Ronnie772/Ronnie772.github.io/docs/index.md

---
title: Welcome
tags:
- tag1
- tag2
---
<center>
<font size = "6">Raunak Singh Datasheet</font><br>
as part of<br>
<font size= "8"> Garden Buddy</font><br>
for<br>
<font size= "5"> Team 201 </font><br>

**Submission: DEC/08/2025**
</center>

after_soldering_front

## Introduction

* These pages describe the construction of the motor subsystem for the Garden Buddy.

<br> 

### Project Summary

* Our goal witht the Garden Buddy is to bring automation to the green thumb so that everyone can enjoy a green and healthy environment at the comfort of their homes.
* We have desgined a moisture sensor that detects the hydration of the soil and lets our motor subsystem know when to open and close the valves to the water tank, irrigating the soil and maintaining the plants. We have a light sensor and a speaker that lets the user know when there isn't enough light or if the water tank is empty. 

<br>

### My Contribution

* My part of the project was to design, build and test th emotor subsystem. This smart irrigation system "Garden Buddy" detects the hydration of the soil and opens the water valves to irrigate the soil keeping the plant healthy and ensuring their long life with minimal user interaction.

* To review the detials of the Block Diagram click [*here*](https://ronnie772.github.io/01-Block-Diagram/Block-Diagram/)

* To review the detials of the Component Selection process click [*here*](https://ronnie772.github.io/02-Component-Selection/Component-Selection/)

* To review the detials of the Schematic click [*here*](https://ronnie772.github.io/04-Schematic/schematic/)

* To review the detials of the Power Budget click [*here*](https://ronnie772.github.io/05-Power-Budget/Power-Budget/)

<br>

Team Report can be found [*here*](https://asu-egr304-2025-f-201.github.io/).

---
| **Team Member** |**Ind. Datasheet Links** |
| --- | ---|
| Jacob Alger | [JacobAlger.GitHub](https://jacob-alger.github.io/)|
| Isaiah Johnston | [Isaiahcmd.GitHub](https://isaiahcmd.github.io/)|
| Rylee Wirt | [rmwirt-source.GitHub](https://rmwirt-source.github.io)|
