Ronnie772/Ronnie772.github.io/docs/06-PCB-Design/06-PCB-Design.md

---
title: PCB - Design
---

## Overview
The PCB for Motor Subsystem of Garden Buddy project implements the PIC18F57Q43 Curiosity Nano, the FAN8100N H-bridge driver, and connectors for the Pololu DC motor and team sensor interfaces. A 9v barrel jack supplies power to the onboard LM7805 linear regulator, which generates the regulated 5v rail used by the microcontroller, H-bridge, indicator LED, and override switches. Additional components such as pull-down resistors, bypass capacitors, and the safety override switches are placed to ensure stable operation and simplify testing.

<br>

3D rendered PCB image (KiCAD)


<br>

Top layer image of PCB (before soldering)
before_soldering_front

<br>

Bottom layer of PCB (before soldering)
before_soldering_back

<br>

Top layer of the PCB (after partial soldering)
after_soldering_front

<br>

Bottom layer of the PCB (after partial Soldering)
after_soldering_back

## Resouces

All the gbr & drl files can be found in the zip file [*here*](https://github.com/user-attachments/files/23944338/gbr.drl_files_PCB_GARDEN_BUDDY.zip),
and the ecad project files can be found [*here*](https://github.com/user-attachments/files/23466681/subsystem-all-project-ecad-files.egr304-RSC.zip).
