Ronnie772/Ronnie772.github.io/docs/09 Resources/09 Resources.md

---
title: Resources
tags:
- tag1
- tag2
---
## Overview
The Resources section provides all design files and supporting documentation necessary to review, replicate, or further develop the motor subsystem hardware and firmware. This includes the full MPLAB project used to program and test the PIC18F57Q43 microcontroller, as well as the complete KiCad project files for the motor subsystem PCB. Together, these files offer a comprehensive reference for both the electrical design and embedded software used in the Garden Buddy system.

The MPLAB project contains the source code, configuration settings, and MCC-generated drivers that implement PWM motor control, override logic, sensor interfacing, and subsystem communication. These files allow future developers to rebuild, modify, or extend the firmware without recreating the environment from scratch.

The KiCad project provides the schematic, PCB layout, component libraries, and fabrication outputs for Hardware V1.0 of the motor subsystem. These resources support hardware debugging, revision planning, and the development of an improved Hardware V2.0 design. Gerber files, BOMs, 3D models, and manufacturing notes are also included to facilitate board fabrication and assembly.

[Block diagram PDF](https://github.com/user-attachments/files/23423738/block-diagram-RSC.drawio.1.pdf).

[Schematic PDF](https://github.com/user-attachments/files/23864050/Subsystem-schematic-design-RSC-.pdf)

[BOM xlsx](https://github.com/user-attachments/files/23973200/Bill_of_Materials_egr304.xlsx)

[MPLAB X PROJECT](https://github.com/user-attachments/files/24046420/Subsystem-Motor_egr304_.zip)

[GBR & DRL files from KiCAD](https://github.com/user-attachments/files/23944338/gbr.drl_files_PCB_GARDEN_BUDDY.zip)

[ecad project files from KiCAD](https://github.com/user-attachments/files/23466681/subsystem-all-project-ecad-files.egr304-RSC.zip).
