Ronnie772/Ronnie772.github.io/docs/05-Power-Budget/Power-budget-rsc.pdf

Team Number: | Team 201
Project Name: | Garden Buddy
Team Member Names: | Raunak Singh Chhabra, Isaiah Johnston, Jacob Alger, Rylee Wirt
Version: | 1
All Major Components Component Name Part Number Supply Voltage Range # Absolute Maximum Current (mA) | Total Current (mA) | Unit
Motor M1N1FB11G 1V to 6V 1 1100 | 1100 mA
Barrel Jack | PJ-102AH | 24V | 1 | 5000 | 5000 mA
5V regulator | LM7805T | 7V to 35V | 2 | 1500 | 3000 mA
Curiosity Nano Board | PIC18F57Q43 | 1.8V to 5.5V | 1 | 500 | 500 mA
+5V Power Rail (1) Component Name Part Number Supply Voltage Range # Absolute Maximum Current (mA) | Total Current (mA) | Unit
Curiosity Nano Board PIC18F57Q43 1.8V to 5.5V 1 500 Subtotal Safety Margin Total Current Required on +5V Rail c3. Regulator or Source Choice 5V regulator LM7805T 7V to 35V 1 1500 Total Remaining Current Available on +5V Rail | 500 mA 500 mA 25% 625 mA 1500 mA 875 mA | mA
+5V Power Rail (2) Component Name Part Number Supply Voltage Range # Absolute Maximum Current (mA) | Total Current (mA) | Unit
Motor M1N1FB11G 1V to 6V 1 1200 Subtotal Safety Margin Total Current Required on +5V Rail c2. Regulator or Source Choice 5V regulator LM7805T 7V to 35V 1 1500 Total Remaining Current Available on +5V Rail | 1200 mA 1200 mA 25% 1500 mA 1500 mA 0 mA | mA
+9V Power Rail Component Name Part Number Supply Voltage Range # Absolute Maximum Current (mA) | Total Current (mA) | Unit
5V regulator LM7805T 7V to 35V 1 1500 5V regulator LM7805T 7V to 35V 1 1500 Subtotal Safety Margin Total Current Required on +9V Rail c1. Regulator or Source Choice Barrel Jack PJ-102AH 24V 1 5000 Total Remaining Current Available on +9V Rail | 1500 mA 1500 3000 mA 25% 3750 mA 5000 mA 1250 mA
C. For each power rail above,

# Power Budget for Motor - Raunak Singh

A. List ALL major components (active devices, integrated circuits, etc.) except for power sources, voltage regulators, resistors, capacitors, or passive elements
B. Assign each major component above to ONE power rail below. Try to minimize the number of different power rails in the design.

D. Select a specific external
External Power Source 1 Component Name Part Number Supply Voltage Range Output Voltage Absolute Maximum Current (mA) | Total Current (mA) | Unit
Power Source 1 Selection Plug-in Wall Supply B09ZTKTLGW 110VAC 9V 15000 15000 mA Barrel Jack PJ-102AH 24V 9V 5000 5000 mA
E. Calculate Battery Life (if applicable). For each battery, also check the worst-case lifetime of the battery by indicating the capacity in mAh.
Power Rails Connected to | 5V regulator | LM7805T | 7V to 35V | 5V | 1500 | 1500 mA
| 5V regulator | LM7805T | 7V to 35V | 5V | 1500 | 1500 mA
| | | | | | 7000 mA
Component Name | Part Number | Supply Voltage Range | Capacity (mAh) | Required By Regulators
#REF!

Battery Life | #REF! | hours
Notes
be determined by the dropout design (e.g., a base unit and

Total Remaining Current Available on External Power Source 1
