Ronnie772/Ronnie772.github.io/docs/01-Block-Diagram/block-diagram-RSC.drawio.pdf

| Raunak Sin
| Microchip PIC18F57Q43 Curio
| Digital I/O
RA1 | | RB2 | RC4 | RD0 | RD

Button

RA0 | ADC1
RA1 | ADC2

connector 1

digital | analog
1 | 2 | 3 | 4 | 5 | 6 | 7 | 8

connecto

digital

1 | 2 | 3 | 4 | 5

5V 1.5A voltage regulator

(5v, 1pin)

9V 3A
unregulated
power supply

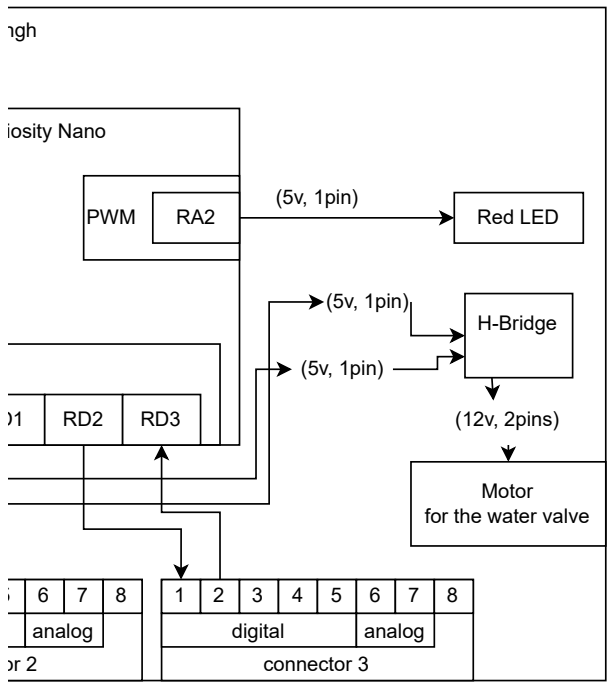
[picture p1: figure]
ngh; iosity Nano; H-Bridge; Motor for the water valve; PWM; Red LED; analog; connector 3; digital; (5v, 1pin); (12v, 2pins)
