Ronnie772/Ronnie772.github.io/docs/01-Block-Diagram/Screenshot 2025-10-21 174000.png

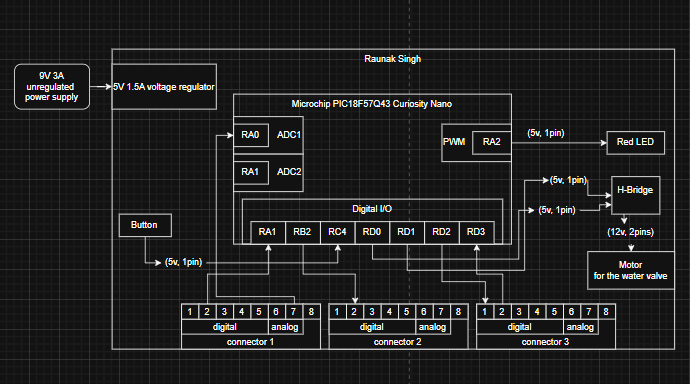
docs/01-Block-Diagram/Screenshot 2025-10-21 174000.png
