Ronnie772/Ronnie772.github.io/docs/04-Schematic/Screenshot 2025-10-20 232314.png

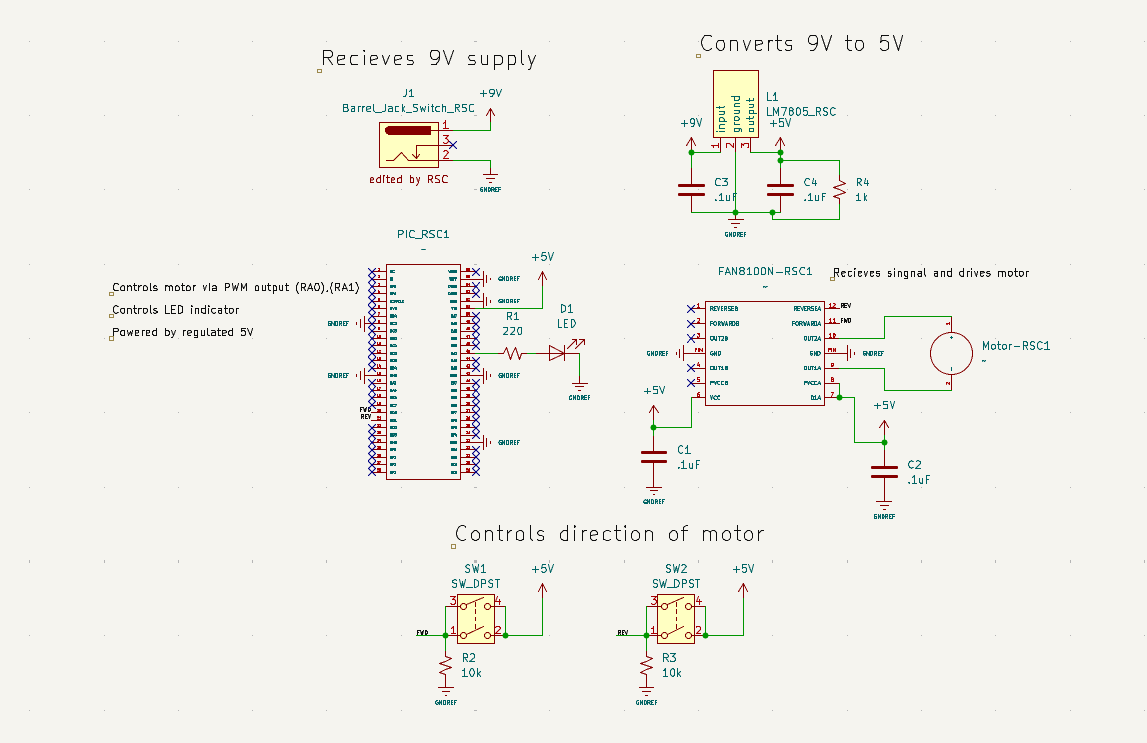
docs/04-Schematic/Screenshot 2025-10-20 232314.png
