Ronnie772/Ronnie772.github.io/docs/04-Schematic/Screenshot 2025-10-22 221519.png

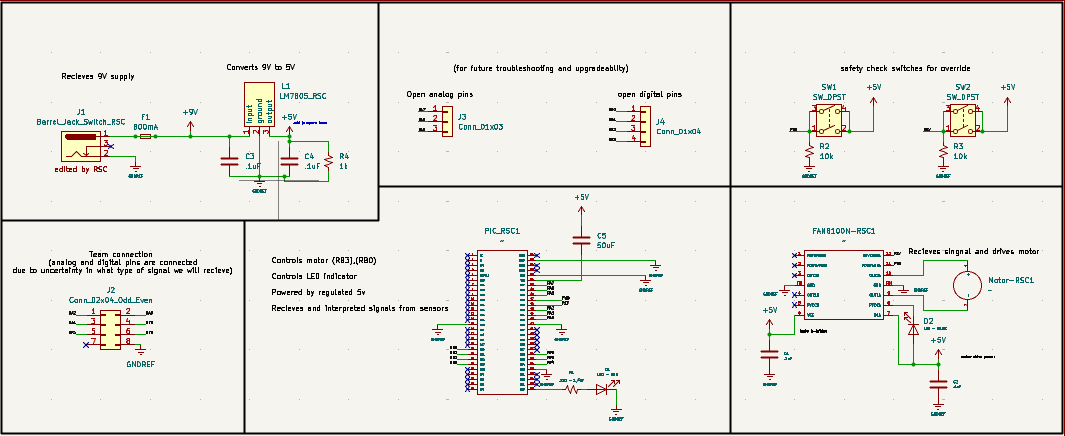
docs/04-Schematic/Screenshot 2025-10-22 221519.png
