Ronnie772/Ronnie772.github.io/docs/04-Schematic/Screenshot 2025-10-27 022820.png

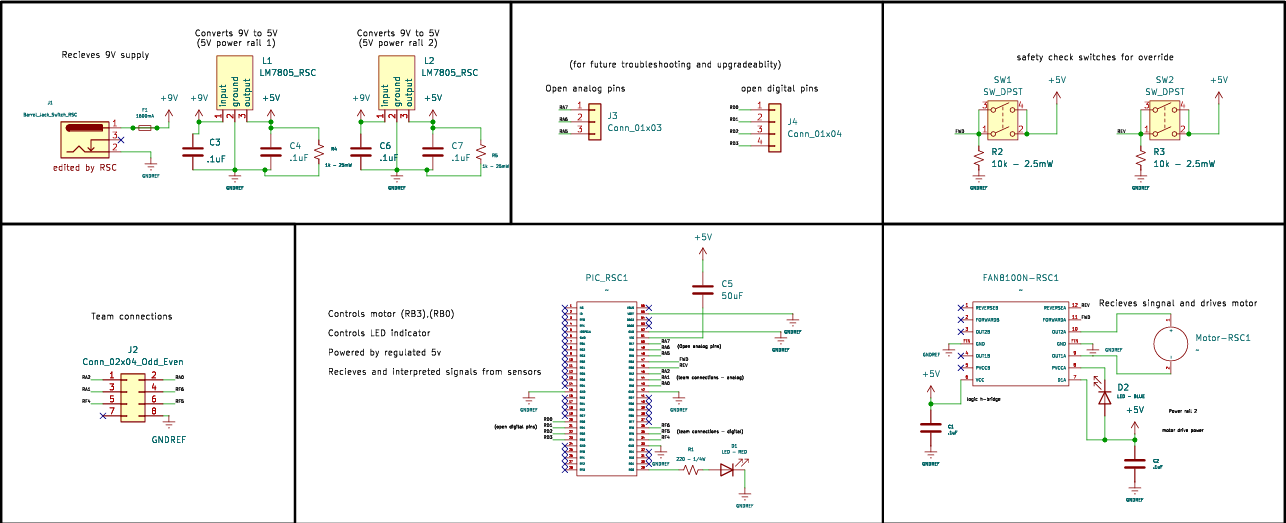
docs/04-Schematic/Screenshot 2025-10-27 022820.png
