Ronnie772/Ronnie772.github.io/docs/03-BOM/BOM.md

---
title: Bill of Materials
tags:
- tag1
- tag2
---

## Overview

This image serves as a complete bill of materials (BOM) for the motor subsystem design, outlining every item needed to assemble the motor subsystem for the Garden Buddy project, it serves as the main reference for the procurement of parts and cost estimation. All the components are readily available through Digi-Key, Amazon and Microchip-Technology and the total cost of the subsystem is,                      

$$ 
$52.20 + $3.20 = $55.40
$$  

<p align="right">{the 5 outsourced JLC PCBs = $3.20}</p>

## Bill of Materials 



You can find the xlsx file [*here*](https://github.com/user-attachments/files/23973200/Bill_of_Materials_egr304.xlsx)
