Ronnie772/Ronnie772.github.io/docs/02-Component-Selection/Component-Selection.md

---
title: Component Selection 
---

**Voltage Regulator**

1. NJM7805FA

   

   * $1.7
   * [Link to product](http://digikey.com/en/products/detail/nisshinbo-micro-devices-inc/NJM7805FA/805763)
  
    | Pros                                                              | Cons                |
    | ----------------------------------------------------------------- | ------------------- |
    | Lightweight                                                       | Higher price |
    |                                                                   |Working temp lower (max- 85°C) |

2. LM7805T

   

   * $0.33
   * [Link to product](https://www.digikey.com/en/products/detail/taejin/LM7805T/22237260)
  
    | Pros                                                              | Cons                |
    | ----------------------------------------------------------------- | ------------------- |
    | From the kit                                                      | Only sold in bulk ($33/100) |
    | Inexpensive                                                       |                      |

3. LM7805R

   

   * $0.33
   * [Link to product](https://www.digikey.com/en/products/detail/taejin/LM7805R/22237269)
  
    | Pros                                                              | Cons                |
    | ----------------------------------------------------------------- | ------------------- |
    | Surface mount                                                     | Only sold in bulk ($266.66/800) |
    | Better  thermal conductivity                                      |                      |

**Choice:** Option 2: LM7805T

**Rationale:** The LM7805T has a 5V 1500mA output, it is inexpensive and efficient, the output matches our requerments perfectly and fits the power budget as well, since it is one of th parts provided by the class it makes most sense to choose this voltage regulator.

**Motors**

1. M1N10FB11G 5V motor

     

    * $3.19/each
    * [link to product]((https://www.digikey.com/en/products/detail/nmb-technologies-corporation/M1N10FB11G/2417078))

    | Pros                                      | Cons                           |
    | ----------------------------------------- | ------------------------------ |
    | Inexpensive                               | Low torque                     |
    | Perfectly matches 5V rail                 | Tendency to spike in amperage when turned on |
    | Lightweight                               | Requires a diffrent Voltage regulator |
    | Available for bulk order for replacements |                                |
   
2. SE15K1BTYJ 12V motor
   
    

    * $9.24/each
    * [Link to product](https://www.digikey.com/en/products/detail/nmb-technologies-corporation/SE15K1BTYJ/6021448)

    | Pros                                                              | Cons                |
    | ----------------------------------------------------------------- | ------------------- |
    | Higher Torque                                                     | Higher Price        |
    | Small and compact                                                 | Requires a diffrent Voltage regulator |

3. 2371 6V motor (Pololu)

   

   * $23.95
   * [Link to product](https://www.digikey.com/en/products/detail/pololu/2371/10450018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)

    | Pros                                                              | Cons                |
    | ----------------------------------------------------------------- | ------------------- |
    | Highest Torque                                                    | Higher Price        |
    | Small and compact                                                 | Low RPM             |
    | Doesn't require an additional power rail                          |                     |
    | Lightweight                                                       |                     |
    
**Choice:** Option 3: 2371 6V motor (Pololu)

**Rationale:** The 2371 6v motor by Pololu is perfect match for our 5v power rail and eliminates the need for an extra one, keeping the PCB design simple. It is lightweight and has the highest toque output, therefore saving cost and increasing productivity.

**H-Bridge**

1. FAN8100N

   

   * $1.16
   * [Link to product](https://www.digikey.com/en/products/detail/rochester-electronics-llc/FAN8100N/11558200)
  
    | Pros                                                              | Cons                |
    | ----------------------------------------------------------------- | ------------------- |
    | From the kit                                                      | Low working temp (75°C) |
    | Through hole                                                      |                     |

2. DRV8833PWPR

   

   * $2.6
   * [Link to product](https://www.digikey.com/en/products/detail/texas-instruments/DRV8833PWPR/2743167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)
  
    | Pros                                                              | Cons                |
    | ----------------------------------------------------------------- | ------------------- |
    | Built-in overcurrent and undervoltage protection                  | Higher price        |
    | Higher working temp (150°C)                                       |                     |
    | Surface mount                                                     |                     |

3. TB6615PG,8

   

   * $2.09
   * [Link to product](https://www.digikey.com/en/products/detail/toshiba-semiconductor-and-storage/tb6615pg-8/7809551)
  
    | Pros                                                              | Cons                |
    | ----------------------------------------------------------------- | ------------------- |
    | Higher working temp (85°C)                                        | Package arrival too late |
    | Fewer pins                                                        |                     |
    | Through hole                                                      |                     |

**Choice:** Option 1: FAN8100N 

**Rationale:** This FAN8100N is an inexpensive and efficient component that fits our requirements perfectly since it is part of the kit provided by the class it also eliminates the need to order an external part, therefore saving cost and increasing productivity. 

**Barrel Jack**

1. PJ-102AH
   
   

   * $0.76
   * [Link to product](https://www.digikey.com/en/products/detail/cui-devices/PJ-102AH/408448)
  
    | Pros                                                              | Cons                |
    | ----------------------------------------------------------------- | ------------------- |
    | From the kit                                                      | Side load fragility |
    | Polybutylene Terephthalate for housing                            |                     |
    |                                                                   |                     |

2. PJ-202A
   
   

   * $0.7
   * [Link to product](https://www.digikey.com/en/products/detail/same-sky-formerly-cui-devices/pj-202a/252007)
  
    | Pros                                                              | Cons                |
    | ----------------------------------------------------------------- | ------------------- |
    | Polybutylene Terephthalate for housing                            | Lower current rating |
    |                                                                   | Package arrival too late |

3. RAPC722X
   
   

   * $2.01
   * [Link to product](https://www.digikey.com/en/products/detail/switchcraft-inc/rapc722x/804747)
  
    | Pros                                                              | Cons                |
    | ----------------------------------------------------------------- | ------------------- |
    | Better solder joint reliability                                   | Higher price |
    |                                                                   |Housing material specified as thermoplastic no specifications given |

**Choice:** Option 1: PJ-102AH

**Rationale:** The PJ-102AH is an inexpensive and highly efficient barrel jack switch, it is part of the kit provided by the class and it fulfills our requirements hence eliminating the need to order an external part, saving cost and increasing productivity.

<br>

**FINAL MAJOR COMPONENT SELECTION**

| **Component** | **Product** |
|---|---|
| Barrel Jack | PJ-102AH |
| Voltage regulator | LM7805T |  
| H-Bridge | FAN8100N  |
| Motor | 2371 (Pololu) |

<br>

**MCC CONFIGURATION**

The image below shows the MCC configuration used for the Motor subsystem in the GARDEN BUDDY project, the pins represent the interaction of the components with the microcontroller PIC18F57Q43. The Motor gets it's directional information the RF5 siganl deteting pin that processes the information and turns the motor either REV using the RB0 pin or FWD using the RB3 pin, meanwhile the RC0 pin provides a constant power to the debug RED-LED.

<br>
