Ronnie772/Ronnie772.github.io/docs/02-Component-Selection/Individual-Component-Design-RSC - Google Docs.pdf

TEAM 201 | Raunak Singh | Individual Component Design

List of major components
Component Name | Part Number | Description | Digikey Links | Images
Button | From the kit
H-Bridge | FAN8100N | BRUSH DC MOTOR CONTROLLER | FAN8100N (https://www.digikey.com/en/products/detail/rochester-electronics-llc/FAN8100N/11558200)

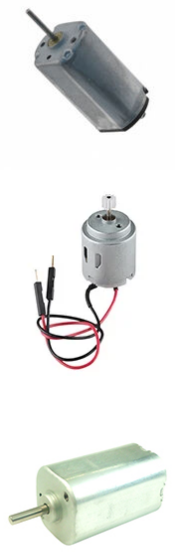
[picture p9: figure]

Motor | M1N10FB11G,

11696,

SE15K1BTYJ

STANDARD
MOTOR 13850
RPM 5V

STANDARD
MOTOR 6600
RPM 12V

STANDARD
MOTOR 6700
RPM 12V

M1N10FB11G (https://www.digikey.com/en/products/detail/nmb-technologies-corporation/M1N10FB11G/2417078)

11696 (https://www.digikey.com/en/products/detail/sparkfun-electronics/11696/6163657)

SE15K1BTYJ (https://www.digikey.com/en/products/detail/nmb-technologies-corporation/SE15K1BTYJ/6021448)

Barrel Jack | PJ-102AH | Power Barrel Connector Jack 2.00mm ID (0.079"), 5.50mm OD (0.217") Through Hole, Right Angle

PJ-102AH (https://www.digikey.com/en/products/detail/cui-devices/PJ-102AH/408448)
