Ronnie772/Ronnie772.github.io/docs/03-BOM/Bill_of_Materials_egr304.xlsx

GARDEN BUDDY - MOTOR SUBSYSTEM - BILL OF MATERIALS
Part name | Qty | Cost/unit | Total cost | Manufacturer | Manufacturer part # | Supplier | Vendor part # | Datasheet | Vender link | Schematic reference designators
Motor | 1 | $23.95 | $23.95 | Pololu | 2371 | Digi-Key | 2183-2371-ND | Datasheet (https://www.pololu.com/file/0J1487/pololu-micro-metal-gearmotors-rev-6-1.pdf) | Link (https://www.digikey.com/en/products/detail/pololu/2371/10450018) | Motor-RSC1
FAN8100N | 1 | $0.00 | $0.00 | Fairchild Semiconductor | FAN8100N | Digi-Key | 2156-FAN8100N-FS-ND | Datasheet (https://rocelec.widen.net/view/pdf/1pizbjqffm/FAIRS23777-1.pdf?t.download=true&u=5oefqw) | Link (https://www.digikey.com/en/products/detail/rochester-electronics-llc/FAN8100N/11558200) | FAN8100N - RSC1
Barrel Jack | 1 | $0.00 | $0.00 | Same Sky | PJ-102AH | Digi-Key | CP-102AH-ND | Datasheet (https://www.cuidevices.com/product/resource/pj-102ah.pdf) | Link (https://www.digikey.com/en/products/detail/cui-devices/PJ-102AH/408448) | Barrel_Jack_Switch_RSC
Voltage Regulator LM | 1 | $0.00 | $0.00 | TAEJIN | LM7805T | Digi-Key | 5536-LM7805T-ND | Datasheet (https://www.htckorea.co.kr/Datasheet/Voltage%20Regulator/LM78xx.pdf) | Link (https://www.digikey.com/en/products/detail/taejin/LM7805T/22237260) | L1 - LM7805_RSC
Microcontroller | 1 | $0.00 | $0.00 | Microchip Technology | PIC18F57Q43 | Microchip Technology | PIC18F57Q43 | Datasheet (https://ww1.microchip.com/downloads/aemDocuments/documents/MCU08/ProductDocuments/UserGuides/PIC18F57Q43-Curiosity-Nano-HW-UserGuide-DS40002186B.pdf) | n/a | PIC_RSC1
Fuse - 1500mA | 1 | $0.00 | $0.00 | n/a | n/a | Peralta | n/a | n/a | n/a | F1
Resistor 220 - 1/4W | 1 | $0.00 | $0.00 | n/a | n/a | Peralta | n/a | n/a | n/a | R1
Resistor 10k - 2.5mW | 2 | $0.00 | $0.00 | n/a | n/a | Peralta | n/a | n/a | n/a | R2, R3
LED - RED | 1 | $0.00 | $0.00 | n/a | n/a | Peralta | n/a | n/a | n/a | LED - RED
LED - BLUE | 1 | $0.00 | $0.00 | n/a | n/a | Peralta | n/a | n/a | n/a | LED - BLUE
Capacitor 0.1uF | 4 | $0.00 | $0.00 | n/a | n/a | Peralta | n/a | n/a | n/a | C1,C2.C3.C4
Capacitor 1uF | 1 | $0.00 | $0.00 | n/a | n/a | Peralta | n/a | n/a | n/a | C5
Switch | 2 | $0.00 | $0.00 | n/a | n/a | Peralta | n/a | n/a | n/a | SW1, SW2
8-pin DIP IC Socket | 3 | $0.00 | $0.00 | n/a | n/a | Peralta | n/a | n/a | n/a | Conn_02x04_Odd_Even
