Ronnie772/Ronnie772.github.io/docs/02-Component-Selection/Screenshot 2025-10-21 220703.png

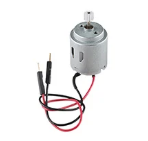
docs/02-Component-Selection/Screenshot 2025-10-21 220703.png
