Ronnie772/Ronnie772.github.io/docs/04-Schematic/Subsystem-schematic-design-RSC-.pdf

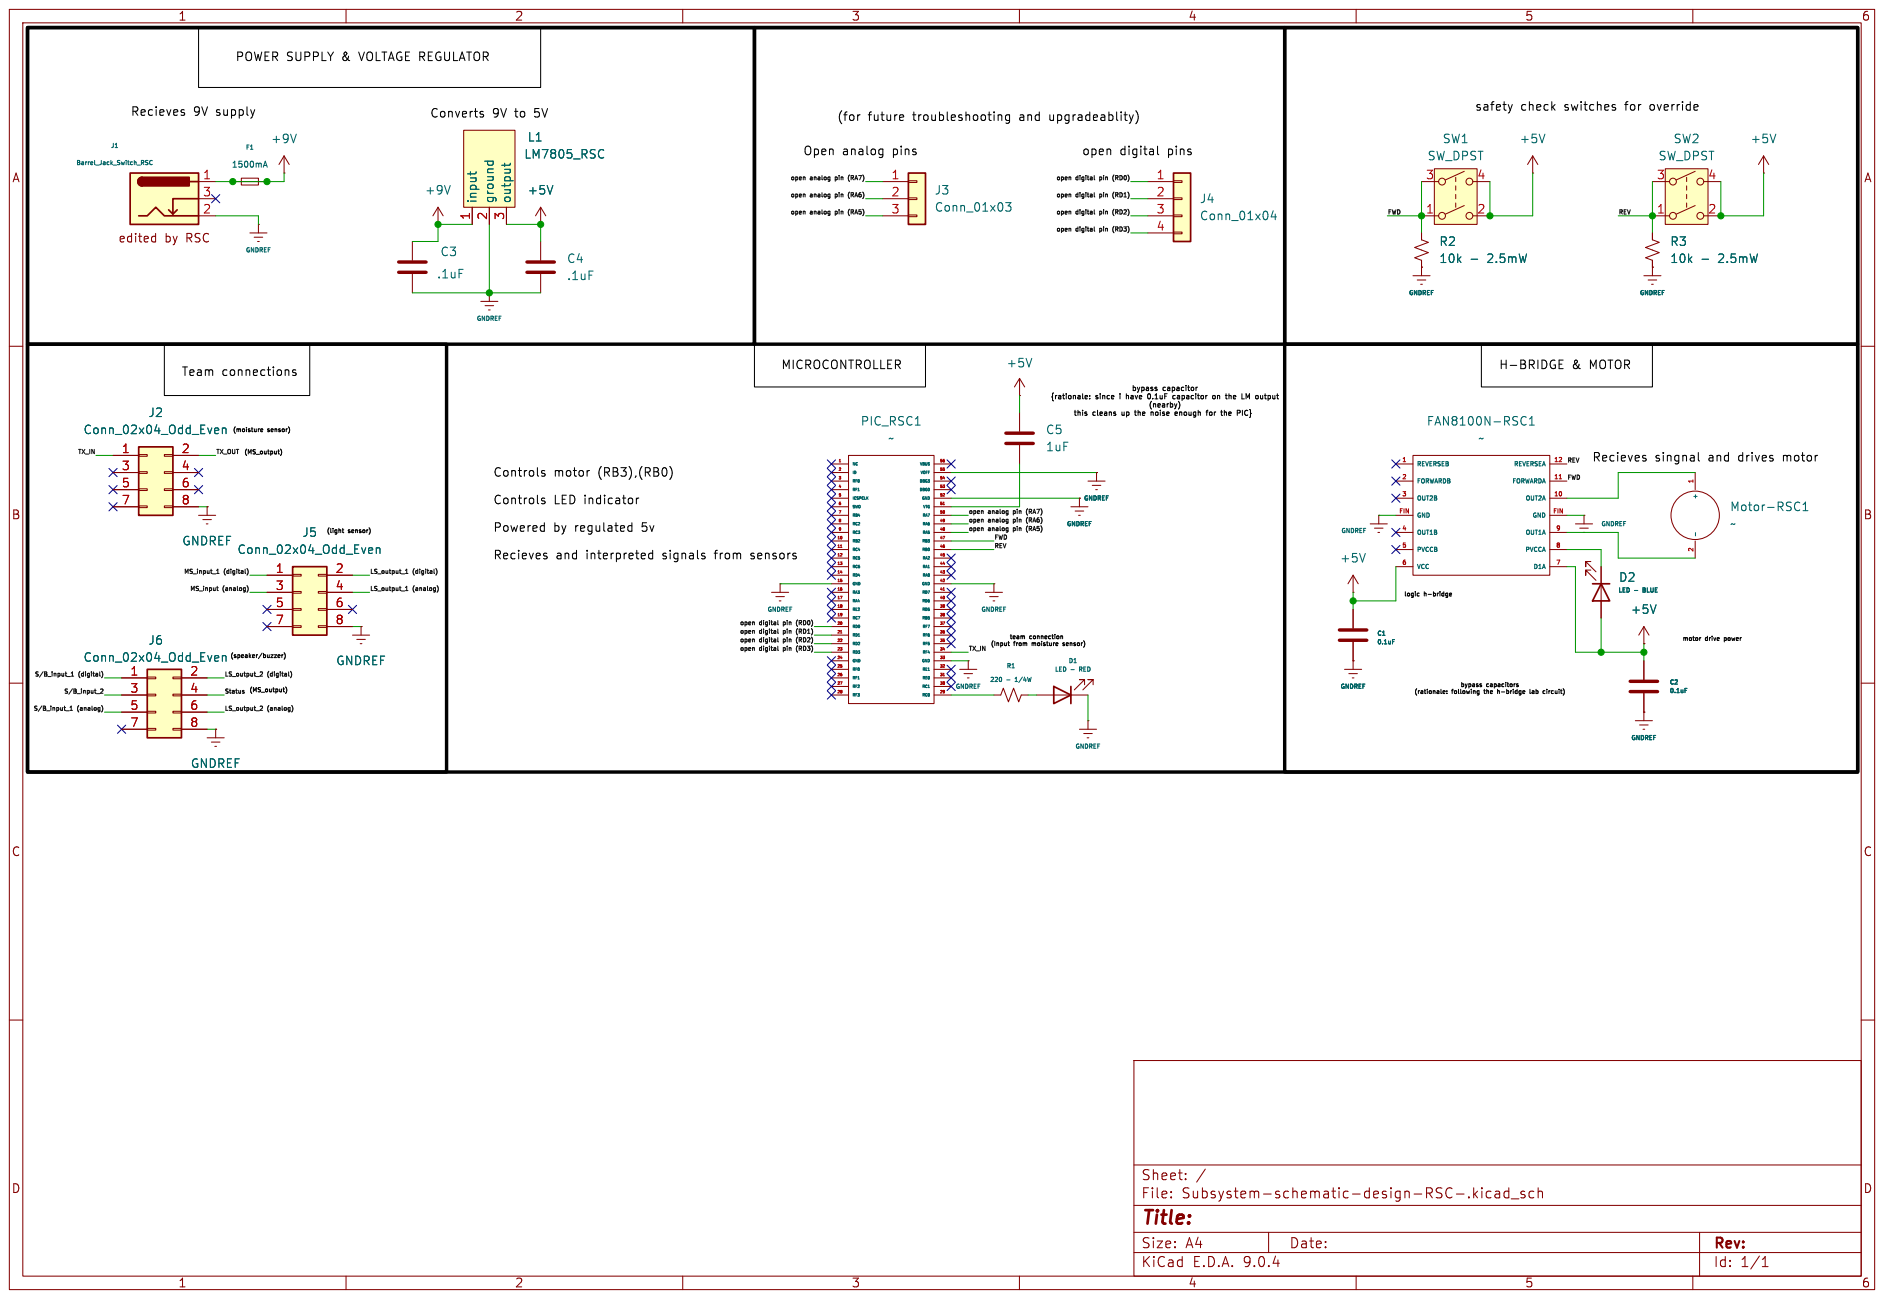
[picture p12: page 1]

Id: 1/1 Title: File: Subsystem-schematic-design-RSC-.kicad_sch Sheet: /
