Ronnie772/Ronnie772.github.io/docs/03-BOM/Subsystem-schematic-design-RSC-.kicad_pcb

## KiCad design docs/03-BOM/Subsystem-schematic-design-RSC-.kicad_pcb (2025-12-06)

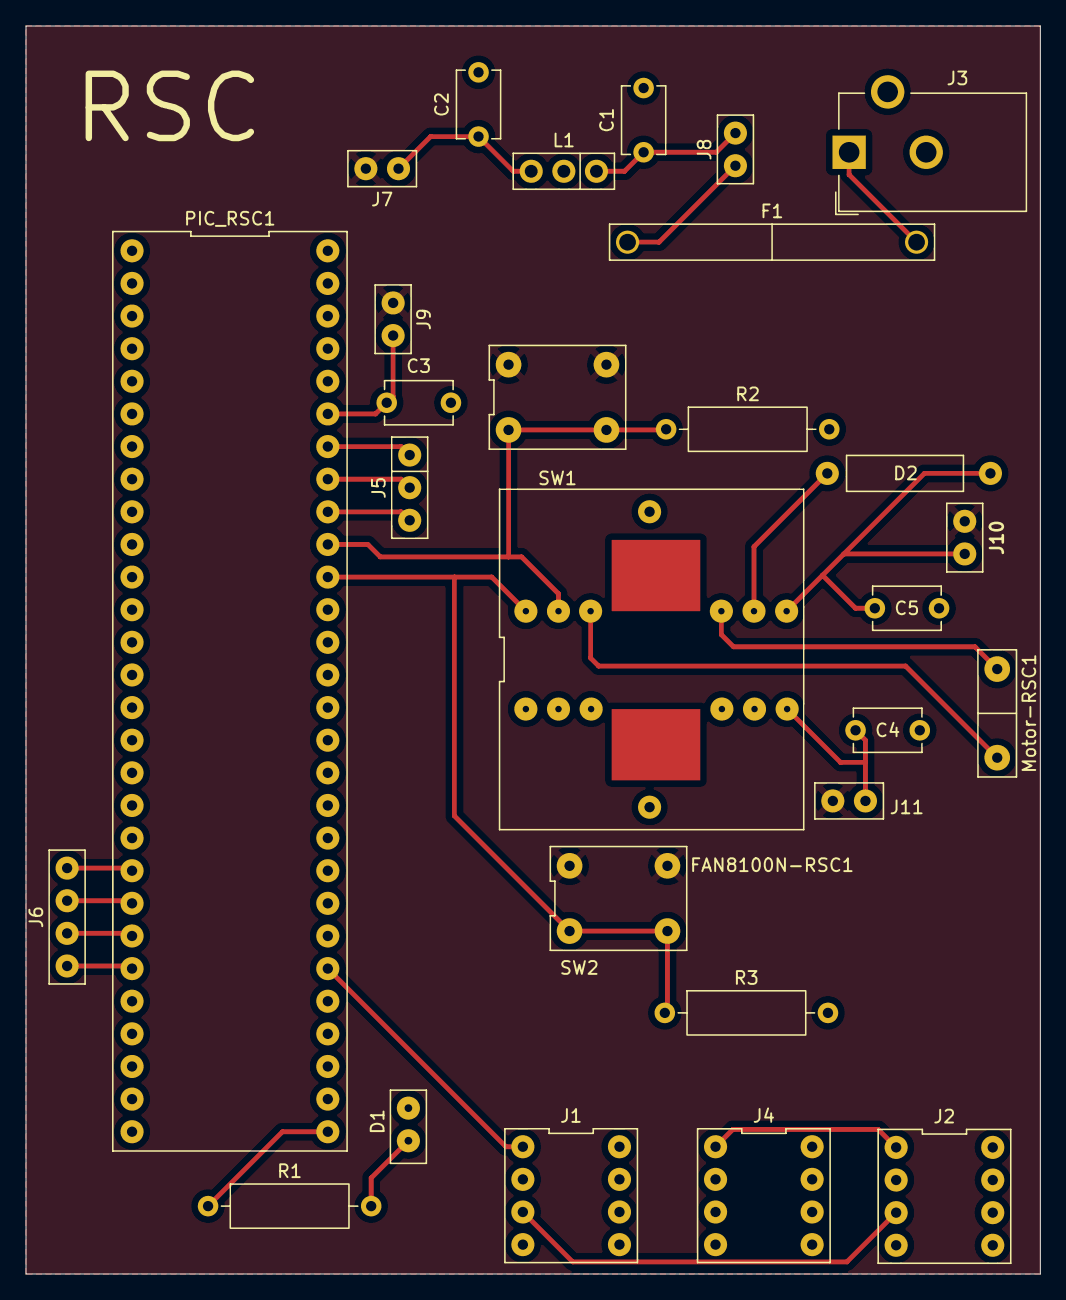
[picture p13: board Subsystem-schematic-design-RSC-.kicad_pcb from above]

Board: 2 copper layers, 79.0 x 97.2 mm, 28 parts (0 on the bottom side), 26 nets.

Parts:
C1: .33uF; C_Disc_D5.1mm_W3.2mm_P5.00mm
C2: .1uF; C_Disc_D5.1mm_W3.2mm_P5.00mm
C3: 1uF; C_Disc_D5.1mm_W3.2mm_P5.00mm
C4, C5: 0.1uF; C_Disc_D5.1mm_W3.2mm_P5.00mm
D1: LED - RED; LED-RSC
D2: D_Small; Diode-RSC(egr304)
F1: 1500mA; fuse-RSC(4628 - Keystone Electronics)
FAN8100N-RSC1: FAN8100N - RSC
J1, J2, J4: Conn_02x04_Odd_Even; 8_pin_ribbon_connector
J3: Barrel_Jack_Switch_RSC; BarrelJack_CUI_PJ-102AH_Horizontal
J5: Conn_01x03; conn_01x03-RSC
J6: Conn_01x04; conn_01x04-RSC
J7, J8, J9, J10, J11: Conn_01x02; header-RSC(egr304)
L1: LM7805_RSC; LM7805T - RSC
Motor-RSC1: MOTOR-RSC(egr304)
PIC_RSC1: Microchip-PIC18F57Q43-RSC
R1: 220 - 1/4W; R_Axial_DIN0309_L9.0mm_D3.2mm_P12.70mm_Horizontal
R2, R3: 10k - 2.5mW; R_Axial_DIN0309_L9.0mm_D3.2mm_P12.70mm_Horizontal
SW1, SW2: SW_DPST; switch-RSC(egr304)

Connections:
+5V: J7.1, J9.2, J10.1, J11.2, SW1.2, SW1.4, SW2.2, SW2.4
+9V: C1.1, J8.1, L1.1 (input)
/FWD: FAN8100N-RSC1.11 (FORWARDA), PIC_RSC1.47 (RB3), R2.1, SW1.1, SW1.3
/HIGH/LOW: J1.1, PIC_RSC1.34 (RF4)
/Low Light Signal: J2.1, J4.1
/REV: FAN8100N-RSC1.12 (REVERSEA), PIC_RSC1.46 (RB0), R3.1, SW2.1, SW2.3
/STATUS: J1.5, J2.5
/open analog pin (RA5): J5.3, PIC_RSC1.48 (RA5)
/open analog pin (RA6): J5.2, PIC_RSC1.49 (RA6)
/open analog pin (RA7): J5.1, PIC_RSC1.50 (RA7)
/open digital pin (RD0): J6.1, PIC_RSC1.20 (RD0)
/open digital pin (RD1): J6.2, PIC_RSC1.21 (RD1)
/open digital pin (RD2): J6.3, PIC_RSC1.22 (RD2)
/open digital pin (RD3): J6.4, PIC_RSC1.23 (RD3)
GNDREF: C1.2, C2.2, C3.2, C4.2, C5.2, D1.1 (K), FAN8100N-RSC1.FIN (GND), FAN8100N-RSC1.FIN2, J1.8, J2.8, J3.2, J4.8, L1.2 (ground), PIC_RSC1.15 (GND), PIC_RSC1.33 (GND), PIC_RSC1.42 (GND), PIC_RSC1.52 (GND), PIC_RSC1.55 (VOFF), R2.2, R3.2
unnamed: D1.2 (A), R1.2
unnamed: C5.1, D2.2 (A), FAN8100N-RSC1.7 (D1A), J10.2
unnamed: D2.1 (K), FAN8100N-RSC1.8 (PVCCA)
unnamed: F1.1, J3.1
unnamed: FAN8100N-RSC1.9 (OUT1A), Motor-RSC1.2 (-)
unnamed: FAN8100N-RSC1.10 (OUT2A), Motor-RSC1.1 (+)
unnamed: C4.1, FAN8100N-RSC1.6 (VCC), J11.1
unnamed: C2.1, J7.2, L1.3 (output)
unnamed: F1.2, J8.2
unnamed: C3.1, J9.1, PIC_RSC1.51 (VTG)
unnamed: PIC_RSC1.29 (RC0), R1.1
