Ronnie772/Ronnie772.github.io/(commit log)

2025-10-21 Update schematic.md
    ss uploaded
2025-11-08 Create 06-PCB
2025-11-10 Create 06-PCB-Design
2025-11-10 Update and rename 06-PCB-Design to 06-PCB-Design.md
2025-11-10 Update and rename 06-PCB-Design.mb to 06-PCB-Design.md
2025-12-01 Update schematic image and resources links
    Updated the schematic image and corrected the PDF link.
2025-12-04 Refine comments in motor control code
    Updated comments for clarity in motor control logic.
2025-12-04 Modify PCB design documentation
    Updated PCB design documentation with new image and corrected resource links.
2025-12-06 Update BOM image and add XLSX file link
    Updated the Bill of Materials image and added a link to the XLSX file.
2025-12-06 Replace BOM image and add XLSX file link
    Updated the BOM image and added a link to the XLSX file.
2025-12-09 Enhance overview of motor subsystem block diagram
    Expanded the overview section to include details about the power supply, microcontroller functionality, PWM control, override switches, and H-bridge operation for the motor subsystem.
2025-12-09 Enhance overview of motor subsystem in documentation
    Expanded the overview section to detail the motor subsystem's components, functionality, and control mechanisms, including PWM signals and override switches for manual control.
2025-12-09 Add H-Bridge and Motor to component selection table
2025-12-09 Document MCC configuration for Motor subsystem
    Added MCC configuration details for the Motor subsystem in the GARDEN BUDDY project, including pin interactions with the PIC18F57Q43 microcontroller.
2025-12-09 Correct Excel sheet link in Power Budget document
    Fix markdown link formatting for Excel sheet.
2025-12-09 Fix link formatting in Power-Budget.md
2025-12-09 Update BOM overview with cost and sourcing details
    Expanded the overview section to include total cost and sourcing information for the motor subsystem.
2025-12-09 Revise schematic overview for motor subsystem
    Updated the schematic overview to include details about power regulation, microcontroller interfaces, and override controls for the motor subsystem.
2025-12-09 Enhance Power Budget documentation with component details
    Added details on component specifications and safety margins for the motor subsystem's power budget.
2025-12-09 Update PCB design documentation with images and resources
    Added images of the PCB design before and after soldering, along with resource links for gbr and ecad project files.
2025-12-09 Update PCB design documentation for partial soldering
2025-12-09 Fix typos and enhance clarity in PCB design doc
    Corrected minor typos and improved clarity in the PCB design documentation.
2025-12-09 Enhance PCB design overview with detailed description
    Expanded the overview section to include details about components and power supply.
2025-12-09 Fix spelling errors in motor subsystem overview
    Corrected spelling errors in the overview section.
2025-12-09 Enhance Resources section with design documentation details
    Added detailed explanation of resources for motor subsystem development.
